my-fi-25073/KEYrschwein/README.md

# Kirschwein
Kirschwein KBD PCB - RC-2XXX
