my-fi-25073/KEYrschwein/OtherFiles/F-edge.dxf

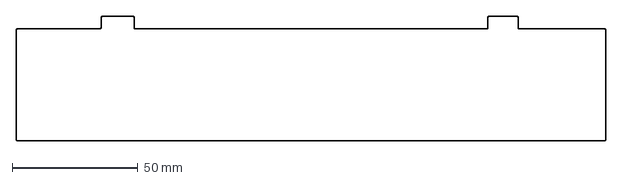
[picture p1: CAD file, 2026-03-09]
OtherFiles/F-edge.dxf
234.0 x 49.5 mm
