my-fi-25073/KEYrschwein/OtherFiles/Kirschwein-2xxa-edge.dxf

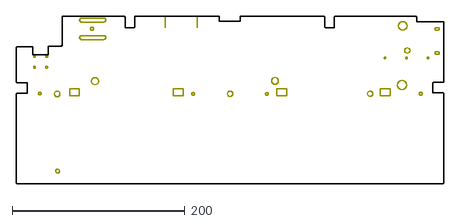
[picture p2: CAD file, 2026-02-23]
OtherFiles/Kirschwein-2xxa-edge.dxf
494.6 x 193.6
