my-fi-25073/KEYrschwein/OtherFiles/2xxx-edge.dxf

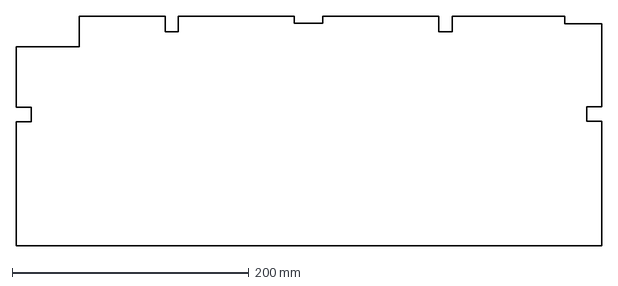
[picture p3: CAD file, 2025-12-20]
OtherFiles/2xxx-edge.dxf
494.6 x 193.6 mm
