my-fi-25073/KEYrschwein/OtherFiles/frow-edge.dxf

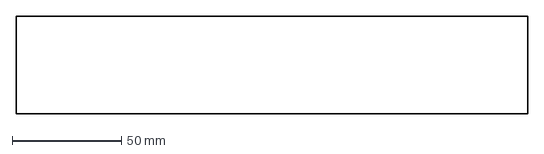
[picture p4: CAD file, 2025-12-20]
OtherFiles/frow-edge.dxf
234.0 x 44.5 mm
