my-fi-25073/KEYrschwein/KiCadFiles/GRAPPA-LEAF20/LEAF20.kicad_pcb

## KiCad design KiCadFiles/GRAPPA-LEAF20/LEAF20.kicad_pcb (2026-03-22)

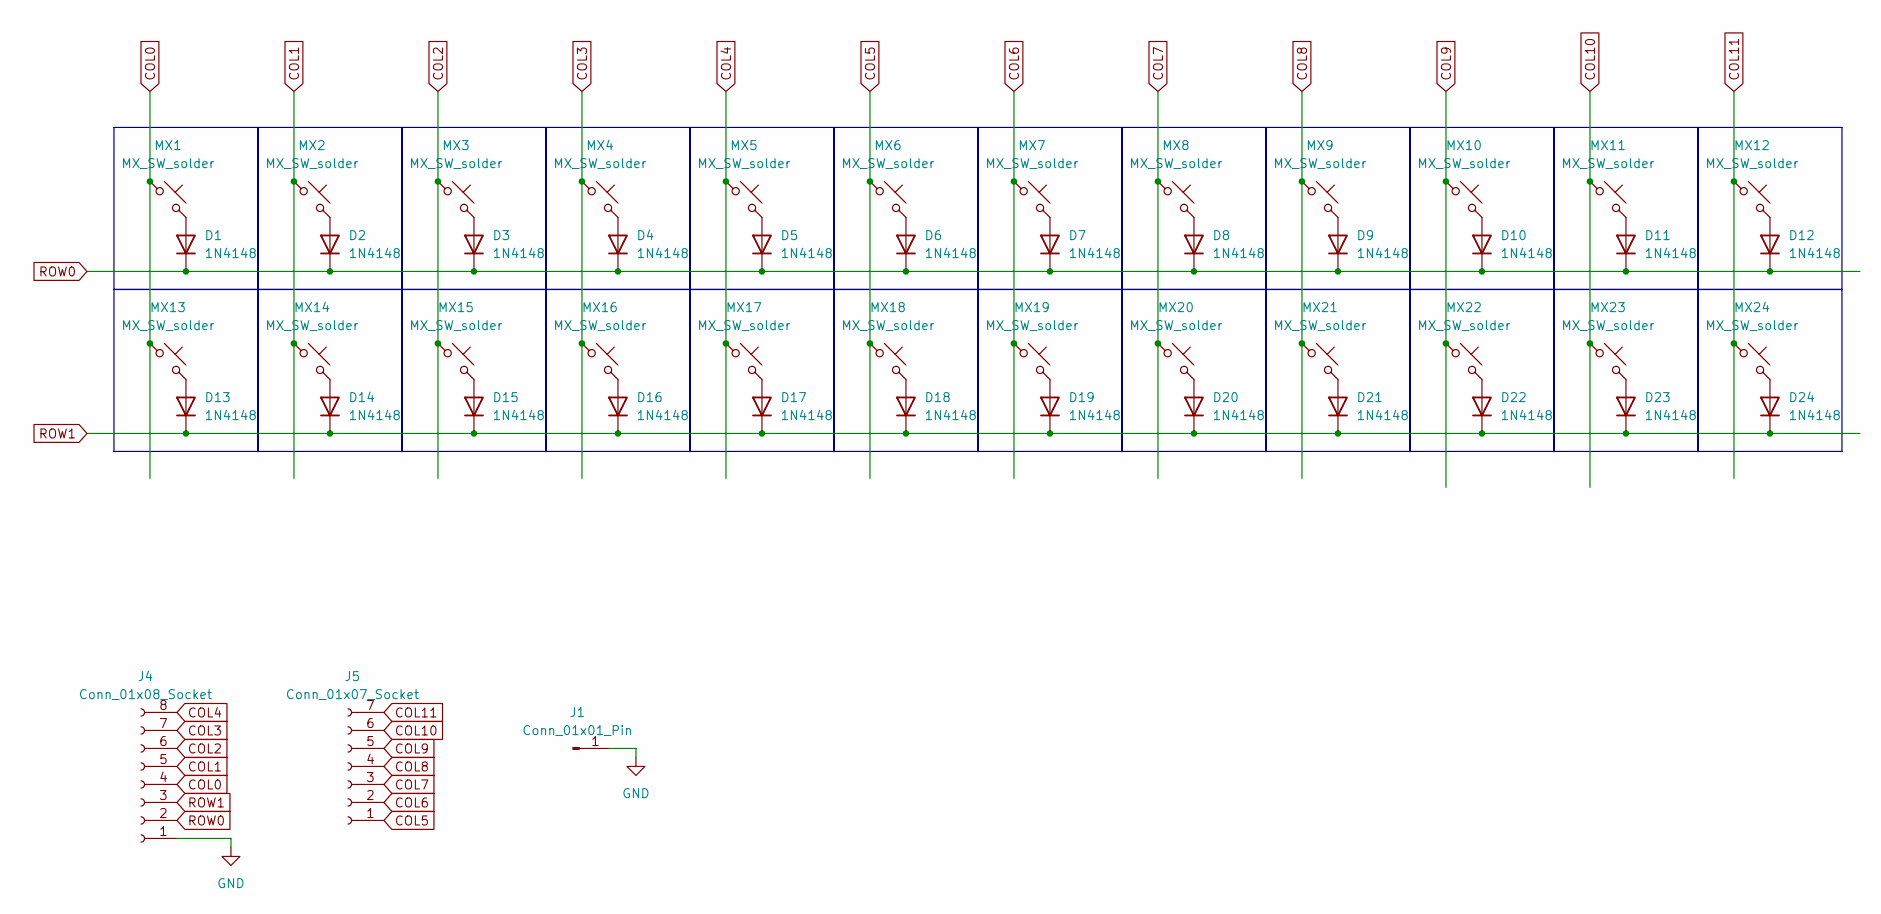
[picture p5: schematic LEAF20.kicad_sch]

Parts:
D1, D2, D3, D4, D5, D6, D7, D8, D9, D10, D11, D12, D13, D14, D15, D16, D17, D18, D19, D20, D21, D22, D23, D24: 1N4148; D_SOD-123-g
J1: Conn_01x01_Pin; SolderWire-0.75sqmm_1x01_D1.25mm_OD2.3mm
J4: Conn_01x08_Socket; JST_SH_SM08B-SRSS-TB_1x08-1MP_P1.00mm_Horizontal
J5: Conn_01x07_Socket; JST_SH_SM07B-SRSS-TB_1x07-1MP_P1.00mm_Horizontal
MX1, MX2, MX3, MX4, MX5, MX6, MX7, MX8, MX9, MX10, MX11, MX12, MX13, MX14, MX15, MX16, MX17, MX18, MX19, MX20, MX21, MX22, MX23, MX24: MX_SW_solder; SW_MX_1u

Connections:
COL0: J4.4, MX1.1, MX13.1
COL1: J4.5, MX2.1, MX14.1
COL2: J4.6, MX3.1, MX15.1
COL3: J4.7, MX4.1, MX16.1
COL4: J4.8, MX5.1, MX17.1
COL5: J5.1, MX6.1, MX18.1
COL6: J5.2, MX7.1, MX19.1
COL7: J5.3, MX8.1, MX20.1
COL8: J5.4, MX9.1, MX21.1
COL9: J5.5, MX10.1, MX22.1
COL10: J5.6, MX11.1, MX23.1
COL11: J5.7, MX12.1, MX24.1
GND: J1.1, J4.1
unnamed: D1.2 (A), MX1.2
unnamed: D2.2 (A), MX2.2
unnamed: D3.2 (A), MX3.2
unnamed: D4.2 (A), MX4.2
unnamed: D5.2 (A), MX5.2
unnamed: D6.2 (A), MX6.2
unnamed: D7.2 (A), MX7.2
unnamed: D8.2 (A), MX8.2
unnamed: D9.2 (A), MX9.2
unnamed: D10.2 (A), MX10.2
unnamed: D11.2 (A), MX11.2
unnamed: D12.2 (A), MX12.2
unnamed: D13.2 (A), MX13.2
unnamed: D14.2 (A), MX14.2
unnamed: D15.2 (A), MX15.2
unnamed: D16.2 (A), MX16.2
unnamed: D17.2 (A), MX17.2
unnamed: D18.2 (A), MX18.2
unnamed: D19.2 (A), MX19.2
unnamed: D20.2 (A), MX20.2
unnamed: D21.2 (A), MX21.2
unnamed: D22.2 (A), MX22.2
unnamed: D23.2 (A), MX23.2
unnamed: D24.2 (A), MX24.2
ROW0: D1.1 (K), D2.1 (K), D3.1 (K), D4.1 (K), D5.1 (K), D6.1 (K), D7.1 (K), D8.1 (K), D9.1 (K), D10.1 (K), D11.1 (K), D12.1 (K), J4.2
ROW1: D13.1 (K), D14.1 (K), D15.1 (K), D16.1 (K), D17.1 (K), D18.1 (K), D19.1 (K), D20.1 (K), D21.1 (K), D22.1 (K), D23.1 (K), D24.1 (K), J4.3

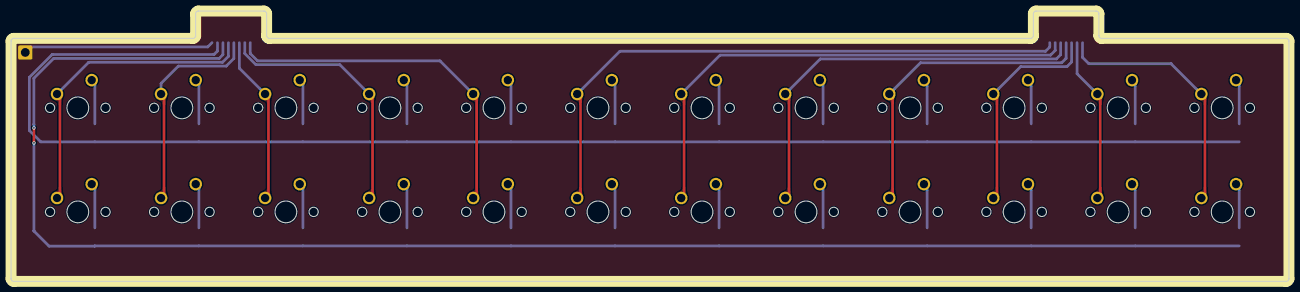
[picture p6: board LEAF20.kicad_pcb from above]

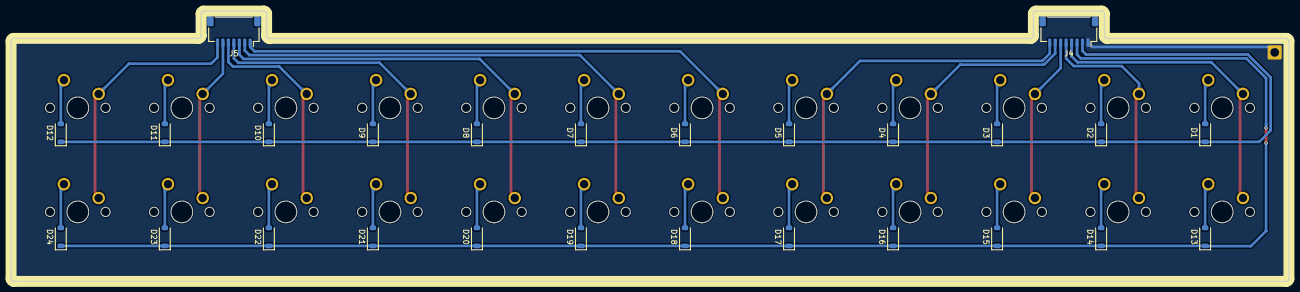
[picture p7: board LEAF20.kicad_pcb from below]

Board: 2 copper layers, 234.0 x 49.5 mm, 51 parts (27 on the bottom side), 39 nets.
