my-fi-25073/KEYrschwein/KiCadFiles/RC-2XXA/RC-2XXA.kicad_pcb

## KiCad design KiCadFiles/RC-2XXA/RC-2XXA.kicad_pcb (2026-03-02)

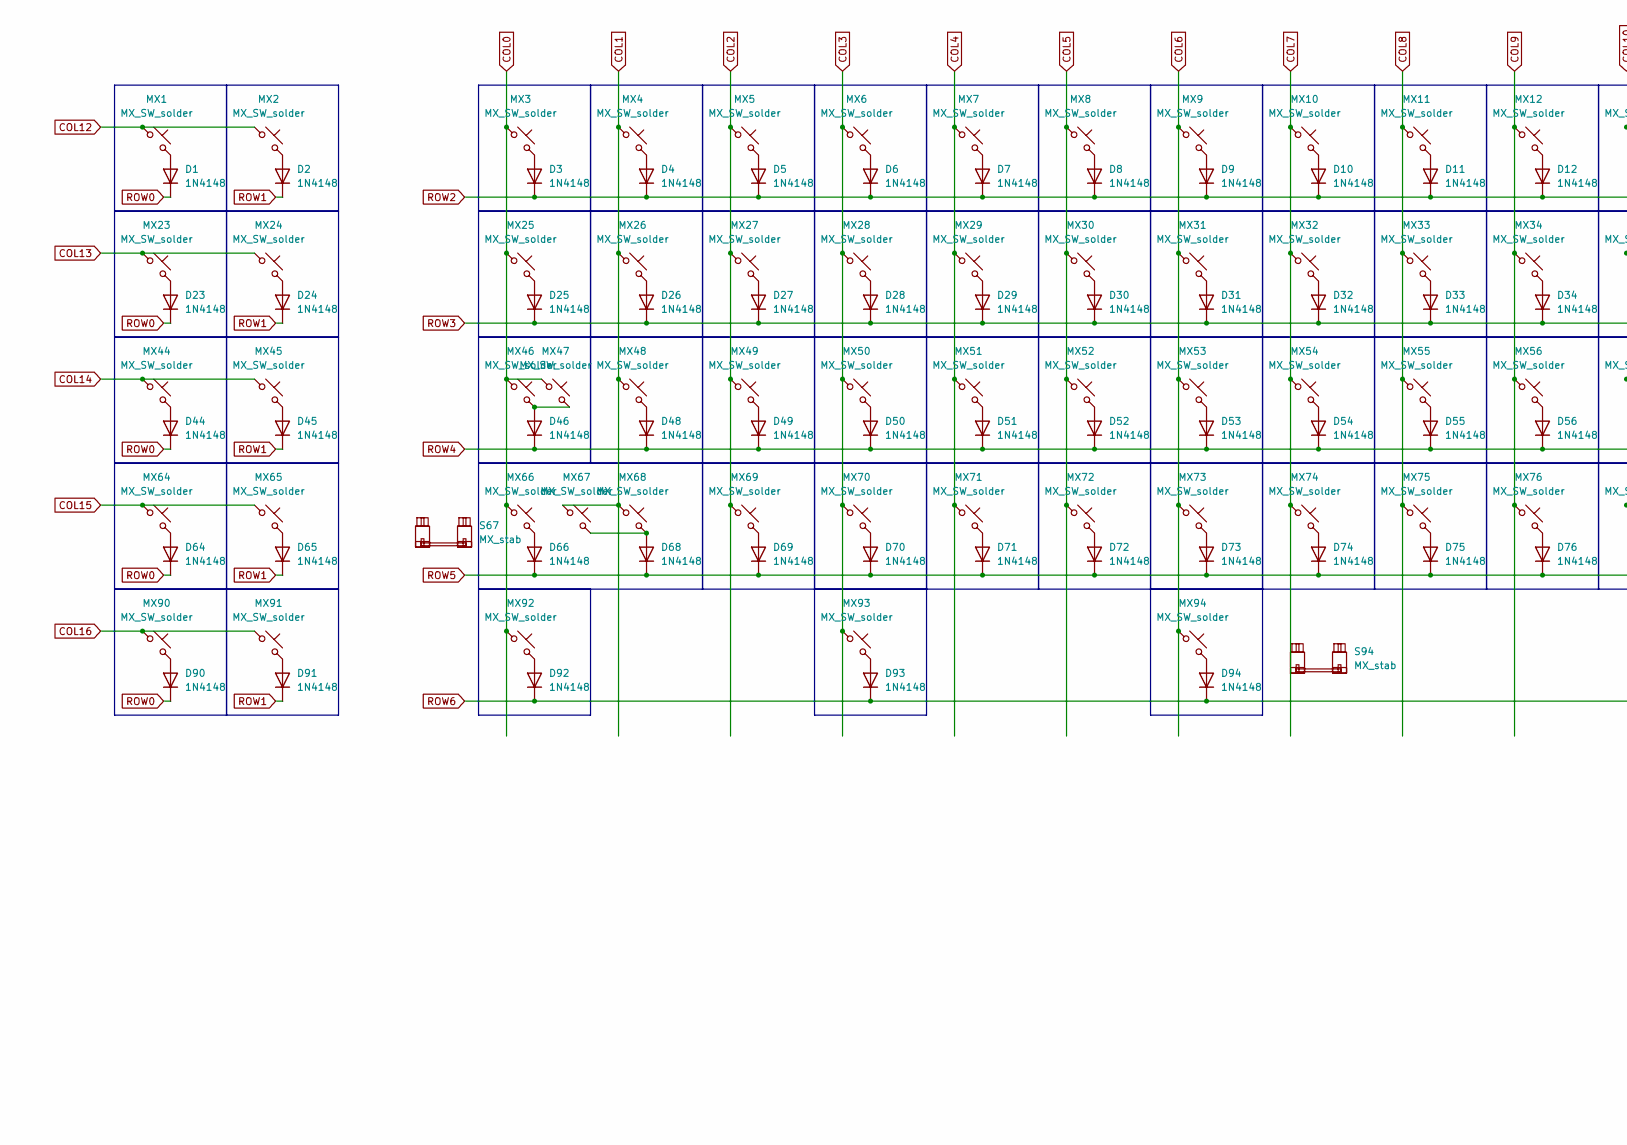
[picture p8: schematic RC-2XXA.kicad_sch, part in row 1, column 1]

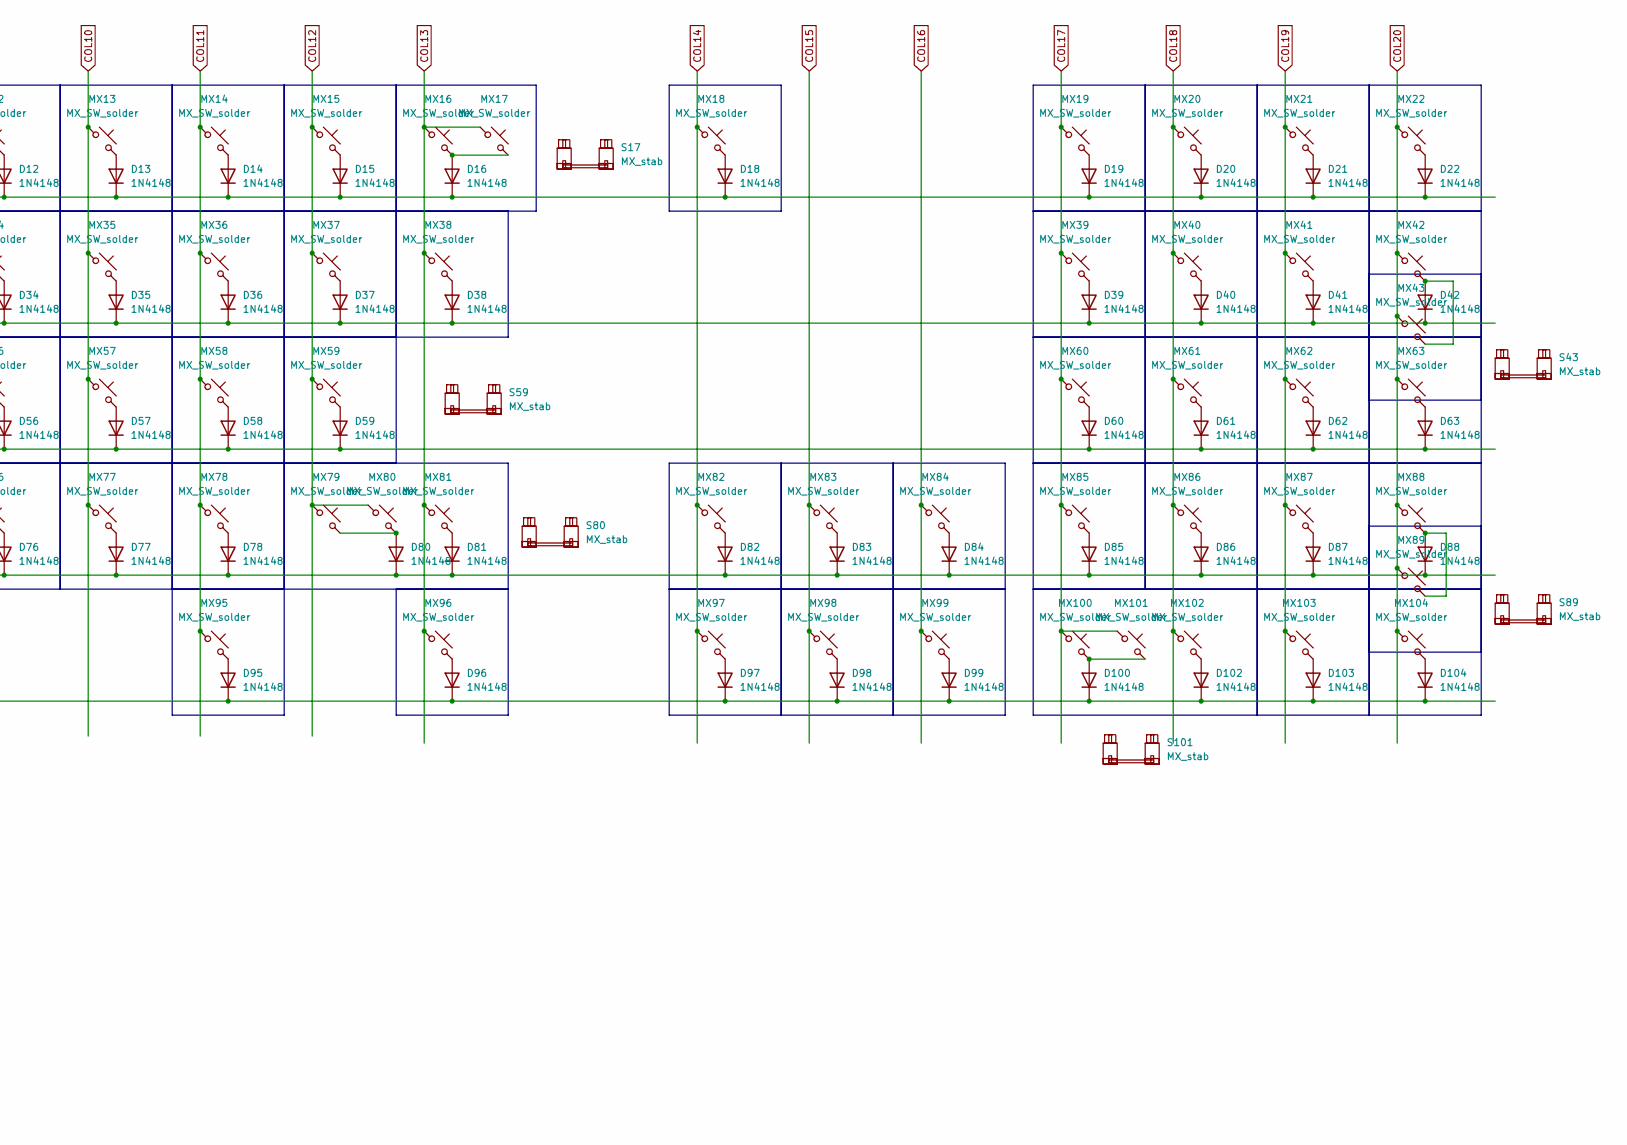
[picture p9: schematic RC-2XXA.kicad_sch, part in row 1, column 2]

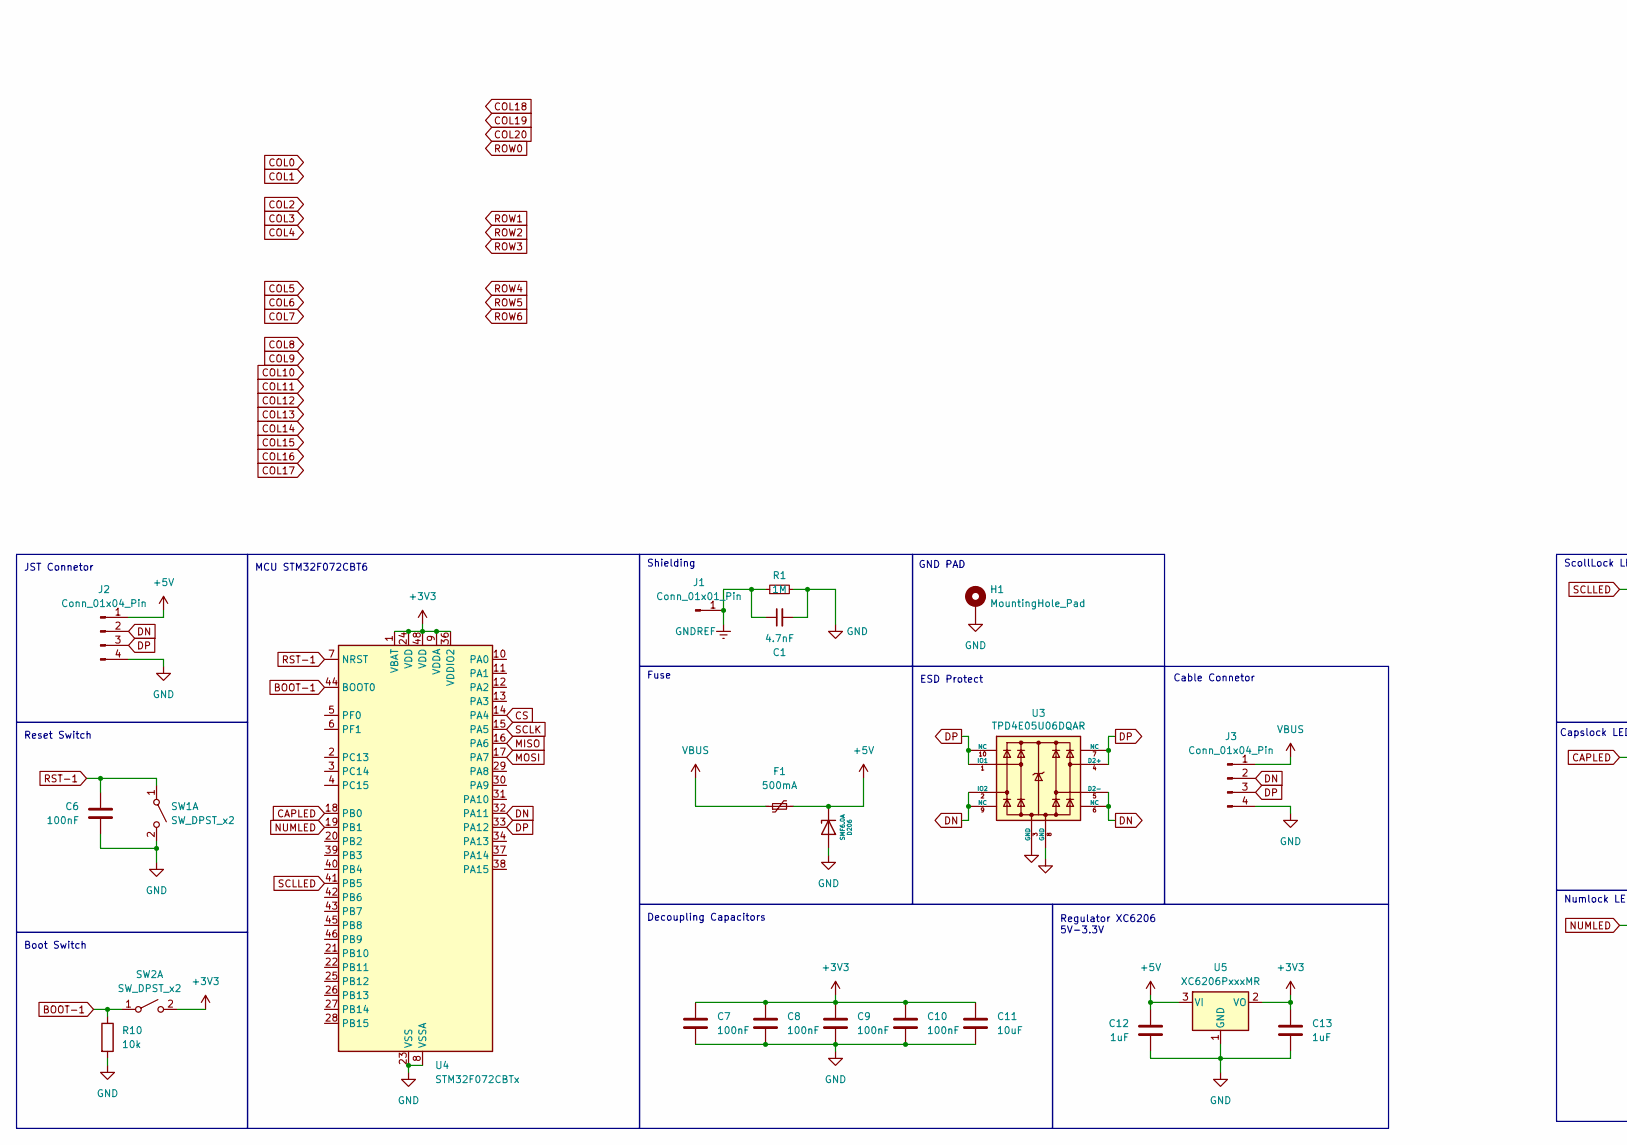
[picture p10: schematic RC-2XXA.kicad_sch, part in row 2, column 1]

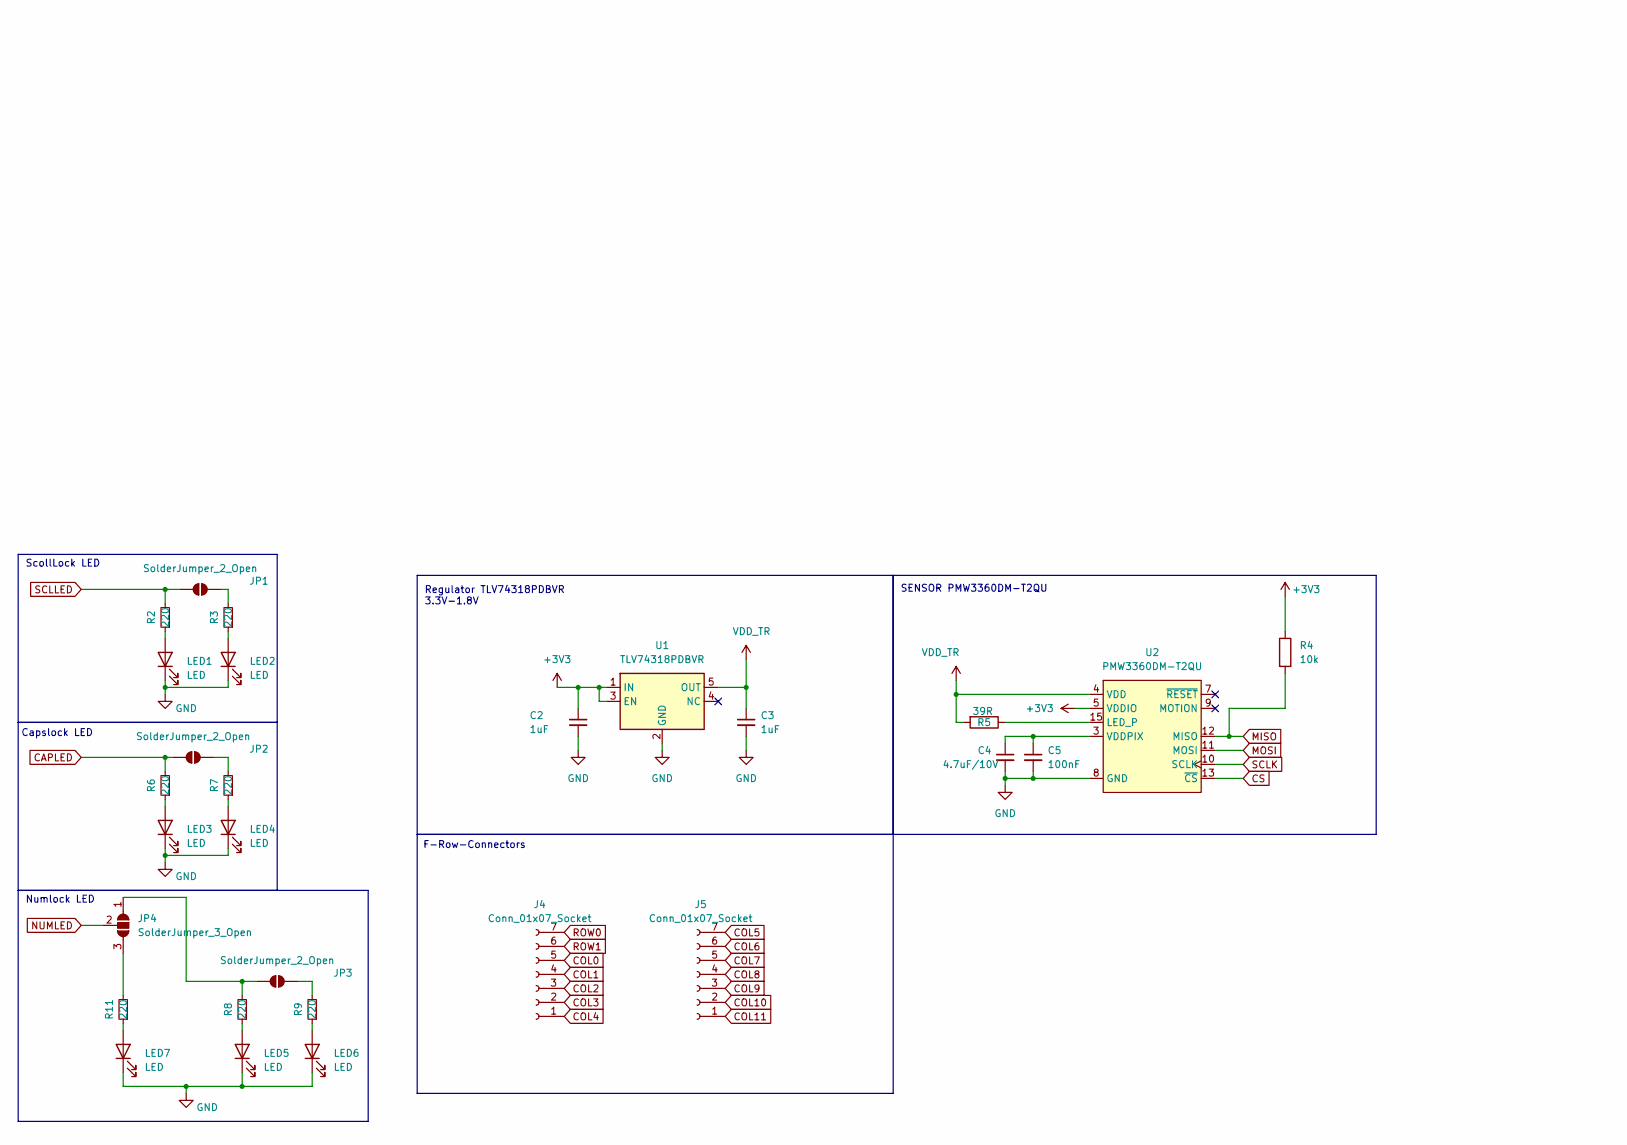
[picture p11: schematic RC-2XXA.kicad_sch, part in row 2, column 2]

Parts:
C1: 4.7nF; C_0805_2012Metric_Pad1.18x1.45mm_HandSolder
C2, C3, C12, C13: 1uF; C_0805_2012Metric_Pad1.18x1.45mm_HandSolder
C4: 4.7uF/10V; C_0805_2012Metric_Pad1.18x1.45mm_HandSolder
C5, C6, C7, C8, C9, C10: 100nF; C_0805_2012Metric_Pad1.18x1.45mm_HandSolder
C11: 10uF; C_0805_2012Metric_Pad1.18x1.45mm_HandSolder
D1, D2, D3, D4, D5, D6, D7, D8, D9, D10, D11, D12, D13, D14, D15, D16, D18, D19, D20, D21, D22, D23, D24, D25, D26, D27, D28, D29, D30, D31, D32, D33, D34, D35, D36, D37, D38, D39, D40, D41, D42, D44, D45, D46, D48, D49, D50, D51, D52, D53, D54, D55, D56, D57, D58, D59, D60, D61, D62, D63, D64, D65, D66, D68, D69, D70, D71, D72, D73, D74, D75, D76, D77, D78, D80, D81, D82, D83, D84, D85, D86, D87, D88, D90, D91, D92, D93, D94, D95, D96, D97, D98, D99, D100, D102, D103, D104: 1N4148; D_SOD-123-g
D206: SMF6.0A; D_SOD-123; Manufacturer Part Number SMF6.0A; LCSC Part Number C708002
F1: 500mA; Fuse_1206_3216Metric; LCSC C70076
H1: MountingHole_Pad; Cherry-GND-PAD
J1: Conn_01x01_Pin; TestPoint_THTPad_2.0x2.0mm_Drill1.0mm
J2: Conn_01x04_Pin; JST_SH_SM04B-SRSS-TB_1x04-1MP_P1.00mm_Horizontal; MPN C160404
J3: Conn_01x04_Pin; My-SolderWire-0.5sqmm_1x04_D0.9mm_OD2.1mm
J4, J5: Conn_01x07_Socket; JST_SH_SM07B-SRSS-TB_1x07-1MP_P1.00mm_Horizontal
JP1, JP2, JP3: SolderJumper_2_Open; SolderJumper-2_P1.3mm_Open_RoundedPad1.0x1.5mm
JP4: SolderJumper_3_Open; SolderJumper-3_P1.3mm_Open_RoundedPad1.0x1.5mm
LED1, LED2, LED4, LED5, LED6, LED7: LED; DIP_LED_MX_3mm
LED3: LED; CAPS_LED_MX_3mm
MX1, MX2, MX3, MX4, MX5, MX6, MX7, MX8, MX9, MX10, MX11, MX12, MX13, MX14, MX15, MX16, MX17, MX18, MX19, MX20, MX21, MX22, MX23, MX24, MX26, MX27, MX28, MX29, MX30, MX31, MX32, MX33, MX34, MX35, MX36, MX37, MX39, MX40, MX41, MX42, MX43, MX44, MX45, MX48, MX49, MX50, MX51, MX52, MX53, MX54, MX55, MX56, MX57, MX58, MX59, MX60, MX61, MX62, MX63, MX64, MX65, MX66, MX67, MX69, MX70, MX71, MX72, MX73, MX74, MX75, MX76, MX77, MX78, MX80, MX81, MX82, MX83, MX84, MX85, MX86, MX87, MX88, MX89, MX90, MX91, MX94, MX97, MX98, MX99, MX100, MX101, MX102, MX103, MX104: MX_SW_solder; SW_MX_1u
MX25, MX38, MX92, MX93, MX95, MX96: MX_SW_solder; SW_MX_1.5u
MX46: MX_SW_solder; SW_MX_1.75u_STP_1.25
MX47, MX79: MX_SW_solder; SW_MX_1.75u
MX68: MX_SW_solder; SW_MX_1.25u
R1: 1M; R_0805_2012Metric_Pad1.20x1.40mm_HandSolder
R2, R3, R6, R7, R8, R9, R11: 220; R_0805_2012Metric_Pad1.20x1.40mm_HandSolder
R4, R10: 10k; R_0805_2012Metric_Pad1.20x1.40mm_HandSolder
R5: 39R; R_0805_2012Metric_Pad1.20x1.40mm_HandSolder
S17, S43, S89, S101: MX_stab; STAB_MX_2u
S59, S67: MX_stab; STAB_MX_2.25u
S80: MX_stab; STAB_MX_2.75u
S94: MX_stab; STAB_MX_7u
SW1, SW2: SW_DPST_x2; SW_Push_1P1T_XKB_TS-1187A; MPN C318884
U1: TLV74318PDBVR; SOT-23-5; MPN C485152
U2: PMW3360DM-T2QU; TrackballHolder_34mm
U3: TPD4E05U06DQAR; USON-10_2.5x1.0mm_P0.5mm; Manufacturer Part Number TPD4E05U06DQAR; LCSC Part Number C138714
U4: STM32F072CBTx; LQFP-48_7x7mm_P0.5mm; MPN C81720
U5: XC6206PxxxMR; SOT-23-3; MPN C5148692

Connections:
+3V3: C2.1, C7.1, C8.1, C9.1, C10.1, C11.1, C13.1, R4.1, SW2.2 (B), U1.1 (IN), U1.3 (EN), U2.5 (VDDIO), U4.1 (VBAT), U4.9 (VDDA), U4.24 (VDD), U4.36 (VDDIO2), U4.48 (VDD), U5.2 (VO)
+5V: C12.1, D206.1 (K), F1.2, J2.1, U5.3 (VI)
BOOT-1: R10.1, SW2.1 (A), U4.44 (BOOT0)
CAPLED: JP2.1 (A), R6.2, U4.18 (PB0)
COL0: J4.5, MX3.1, MX25.1, MX46.1, MX47.1, MX66.1, MX92.1
COL1: J4.4, MX4.1, MX26.1, MX48.1, MX67.1, MX68.1
COL2: J4.3, MX5.1, MX27.1, MX49.1, MX69.1
COL3: J4.2, MX6.1, MX28.1, MX50.1, MX70.1, MX93.1
COL4: J4.1, MX7.1, MX29.1, MX51.1, MX71.1
COL5: J5.7, MX8.1, MX30.1, MX52.1, MX72.1
COL6: J5.6, MX9.1, MX31.1, MX53.1, MX73.1, MX94.1
COL7: J5.5, MX10.1, MX32.1, MX54.1, MX74.1
COL8: J5.4, MX11.1, MX33.1, MX55.1, MX75.1
COL9: J5.3, MX12.1, MX34.1, MX56.1, MX76.1
COL10: J5.2, MX13.1, MX35.1, MX57.1, MX77.1
COL11: J5.1, MX14.1, MX36.1, MX58.1, MX78.1, MX95.1
COL12: MX1.1, MX2.1, MX15.1, MX37.1, MX59.1, MX79.1, MX80.1
COL13: MX16.1, MX17.1, MX23.1, MX24.1, MX38.1, MX81.1, MX96.1
COL14: MX18.1, MX44.1, MX45.1, MX82.1, MX97.1
COL15: MX64.1, MX65.1, MX83.1, MX98.1
COL16: MX84.1, MX90.1, MX91.1, MX99.1
COL17: MX19.1, MX39.1, MX60.1, MX85.1, MX100.1, MX101.1
COL18: MX20.1, MX40.1, MX61.1, MX86.1, MX102.1
COL19: MX21.1, MX41.1, MX62.1, MX87.1, MX103.1
COL20: MX22.1, MX42.1, MX43.1, MX63.1, MX88.1, MX89.1, MX104.1
CS: U2.13 (~CS), U4.14 (PA4)
DN: J2.2, J3.2, U3.2 (IO2), U3.5 (D2-), U3.6 (NC), U3.9 (NC), U4.32 (PA11)
DP: J2.3, J3.3, U3.1 (IO1), U3.4 (D2+), U3.7 (NC), U3.10 (NC), U4.33 (PA12)
GND: C1.2, C2.2, C3.2, C4.2, C5.2, C6.2, C7.2, C8.2, C9.2, C10.2, C11.2, C12.2, C13.2, D206.2 (A), H1.1, J2.4, J3.4, LED1.1 (K), LED2.1 (K), LED3.1 (K), LED4.1 (K), LED5.1 (K), LED6.1 (K), LED7.1 (K), R1.2, R10.2, SW1.2 (B), U1.2 (GND), U2.8 (GND), U3.3 (GND), U3.8 (GND), U4.8 (VSSA), U4.23 (VSS), U4.35 (VSS), U4.47 (VSS), U5.1 (GND)
GNDREF: C1.1, J1.1, R1.1
MISO: R4.2, U2.12 (MISO), U4.16 (PA6)
MOSI: U2.11 (MOSI), U4.17 (PA7)
NUMLED: JP4.2 (C), U4.19 (PB1)
unnamed: D1.2 (A), MX1.2
unnamed: D2.2 (A), MX2.2
unnamed: D3.2 (A), MX3.2
unnamed: D4.2 (A), MX4.2
unnamed: D5.2 (A), MX5.2
unnamed: D6.2 (A), MX6.2
unnamed: D7.2 (A), MX7.2
unnamed: D8.2 (A), MX8.2
unnamed: D9.2 (A), MX9.2
unnamed: D10.2 (A), MX10.2
unnamed: D11.2 (A), MX11.2
unnamed: D12.2 (A), MX12.2
unnamed: D13.2 (A), MX13.2
unnamed: D14.2 (A), MX14.2
unnamed: D15.2 (A), MX15.2
unnamed: D16.2 (A), MX16.2, MX17.2
unnamed: D18.2 (A), MX18.2
unnamed: D19.2 (A), MX19.2
unnamed: D20.2 (A), MX20.2
unnamed: D21.2 (A), MX21.2
unnamed: D22.2 (A), MX22.2
unnamed: D23.2 (A), MX23.2
unnamed: D24.2 (A), MX24.2
unnamed: D25.2 (A), MX25.2
unnamed: D26.2 (A), MX26.2
unnamed: D27.2 (A), MX27.2
unnamed: D28.2 (A), MX28.2
unnamed: D29.2 (A), MX29.2
unnamed: D30.2 (A), MX30.2
unnamed: D31.2 (A), MX31.2
unnamed: D32.2 (A), MX32.2
unnamed: D33.2 (A), MX33.2
unnamed: D34.2 (A), MX34.2
unnamed: D35.2 (A), MX35.2
unnamed: D36.2 (A), MX36.2
unnamed: D37.2 (A), MX37.2
unnamed: D38.2 (A), MX38.2
unnamed: D39.2 (A), MX39.2
unnamed: D40.2 (A), MX40.2
unnamed: D41.2 (A), MX41.2
unnamed: D42.2 (A), MX42.2, MX43.2
unnamed: D44.2 (A), MX44.2
unnamed: D45.2 (A), MX45.2
unnamed: D46.2 (A), MX46.2, MX47.2
unnamed: D48.2 (A), MX48.2
unnamed: D49.2 (A), MX49.2
unnamed: D50.2 (A), MX50.2
unnamed: D51.2 (A), MX51.2
unnamed: D52.2 (A), MX52.2
unnamed: D53.2 (A), MX53.2
unnamed: D54.2 (A), MX54.2
unnamed: D55.2 (A), MX55.2
unnamed: D56.2 (A), MX56.2
unnamed: D57.2 (A), MX57.2
unnamed: D58.2 (A), MX58.2
unnamed: D59.2 (A), MX59.2
unnamed: D60.2 (A), MX60.2
unnamed: D61.2 (A), MX61.2
unnamed: D62.2 (A), MX62.2
unnamed: D63.2 (A), MX63.2
unnamed: D64.2 (A), MX64.2
unnamed: D65.2 (A), MX65.2
unnamed: D66.2 (A), MX66.2
unnamed: D68.2 (A), MX67.2, MX68.2
unnamed: D69.2 (A), MX69.2
unnamed: D70.2 (A), MX70.2
unnamed: D71.2 (A), MX71.2
unnamed: D72.2 (A), MX72.2
unnamed: D73.2 (A), MX73.2
unnamed: D74.2 (A), MX74.2
unnamed: D75.2 (A), MX75.2
unnamed: D76.2 (A), MX76.2
unnamed: D77.2 (A), MX77.2
unnamed: D78.2 (A), MX78.2
unnamed: D80.2 (A), MX79.2, MX80.2
unnamed: D81.2 (A), MX81.2
unnamed: D82.2 (A), MX82.2
unnamed: D83.2 (A), MX83.2
unnamed: D84.2 (A), MX84.2
unnamed: D85.2 (A), MX85.2
unnamed: D86.2 (A), MX86.2
unnamed: D87.2 (A), MX87.2
unnamed: D88.2 (A), MX88.2, MX89.2
unnamed: D90.2 (A), MX90.2
unnamed: D91.2 (A), MX91.2
unnamed: D92.2 (A), MX92.2
unnamed: D93.2 (A), MX93.2
unnamed: D94.2 (A), MX94.2
unnamed: D95.2 (A), MX95.2
unnamed: D96.2 (A), MX96.2
unnamed: D97.2 (A), MX97.2
unnamed: D98.2 (A), MX98.2
unnamed: D99.2 (A), MX99.2
unnamed: D100.2 (A), MX100.2, MX101.2
unnamed: D102.2 (A), MX102.2
unnamed: D103.2 (A), MX103.2
unnamed: D104.2 (A), MX104.2
unnamed: JP1.2 (B), R3.2
unnamed: JP2.2 (B), R7.2
unnamed: JP3.1 (A), JP4.1 (A), R8.2
unnamed: JP3.2 (B), R9.2
unnamed: JP4.3 (B), R11.2
unnamed: LED1.2 (A), R2.1
unnamed: LED2.2 (A), R3.1
unnamed: LED3.2 (A), R6.1
unnamed: LED4.2 (A), R7.1
unnamed: LED5.2 (A), R8.1
unnamed: LED6.2 (A), R9.1
unnamed: LED7.2 (A), R11.1
unnamed: R5.1, U2.15 (LED_P)
unnamed: C4.1, C5.1, U2.3 (VDDPIX)
ROW0: D1.1 (K), D23.1 (K), D44.1 (K), D64.1 (K), D90.1 (K), J4.7
ROW1: D2.1 (K), D24.1 (K), D45.1 (K), D65.1 (K), D91.1 (K), J4.6
ROW2: D3.1 (K), D4.1 (K), D5.1 (K), D6.1 (K), D7.1 (K), D8.1 (K), D9.1 (K), D10.1 (K), D11.1 (K), D12.1 (K), D13.1 (K), D14.1 (K), D15.1 (K), D16.1 (K), D18.1 (K), D19.1 (K), D20.1 (K), D21.1 (K), D22.1 (K)
ROW3: D25.1 (K), D26.1 (K), D27.1 (K), D28.1 (K), D29.1 (K), D30.1 (K), D31.1 (K), D32.1 (K), D33.1 (K), D34.1 (K), D35.1 (K), D36.1 (K), D37.1 (K), D38.1 (K), D39.1 (K), D40.1 (K), D41.1 (K), D42.1 (K)
ROW4: D46.1 (K), D48.1 (K), D49.1 (K), D50.1 (K), D51.1 (K), D52.1 (K), D53.1 (K), D54.1 (K), D55.1 (K), D56.1 (K), D57.1 (K), D58.1 (K), D59.1 (K), D60.1 (K), D61.1 (K), D62.1 (K), D63.1 (K)
ROW5: D66.1 (K), D68.1 (K), D69.1 (K), D70.1 (K), D71.1 (K), D72.1 (K), D73.1 (K), D74.1 (K), D75.1 (K), D76.1 (K), D77.1 (K), D78.1 (K), D80.1 (K), D81.1 (K), D82.1 (K), D83.1 (K), D84.1 (K), D85.1 (K), D86.1 (K), D87.1 (K), D88.1 (K)
ROW6: D92.1 (K), D93.1 (K), D94.1 (K), D95.1 (K), D96.1 (K), D97.1 (K), D98.1 (K), D99.1 (K), D100.1 (K), D102.1 (K), D103.1 (K), D104.1 (K)
RST-1: C6.1, SW1.1 (A), U4.7 (NRST)
SCLK: U2.10 (SCLK), U4.15 (PA5)
SCLLED: JP1.1 (A), R2.2, U4.41 (PB5)
VBUS: F1.1, J3.1
VDD_TR: C3.1, R5.2, U1.5 (OUT), U2.4 (VDD)

Notes on the sheet:
MCU STM32F072CBT6
Numlock LED
Cable Connetor
Shielding
ScollLock LED
Reset Switch
Decoupling Capacitors
Boot Switch
Regulator XC6206 5V-3.3V
JST Connetor
Capslock LED
SENSOR PMW3360DM-T2QU
ESD Protect
F-Row-Connectors
Regulator TLV74318PDBVR 3.3V-1.8V
Fuse
GND PAD

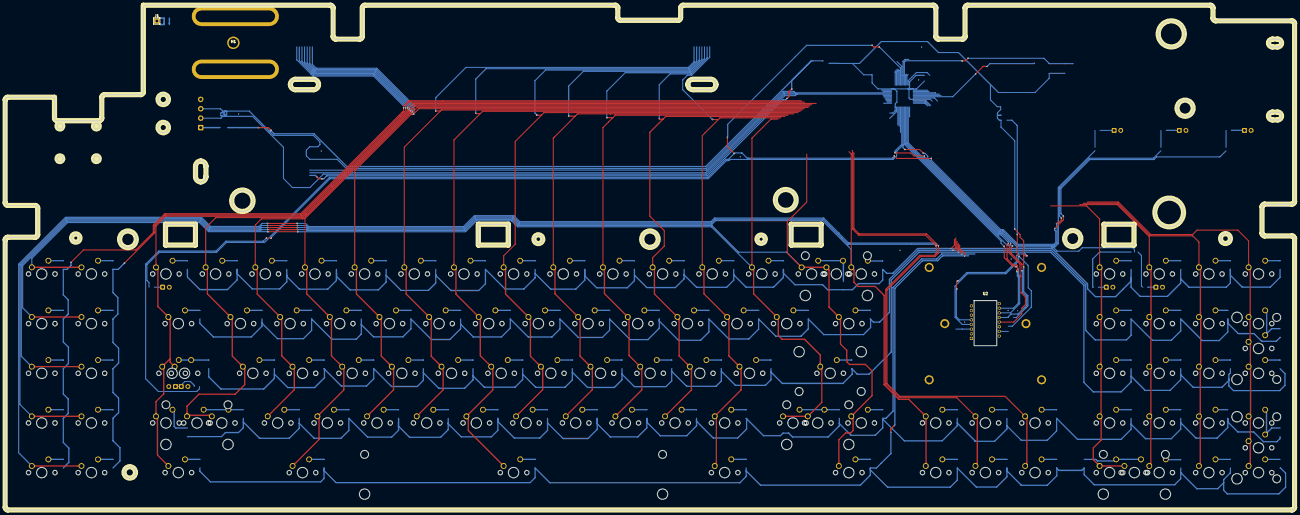
[picture p12: board RC-2XXA.kicad_pcb from above]

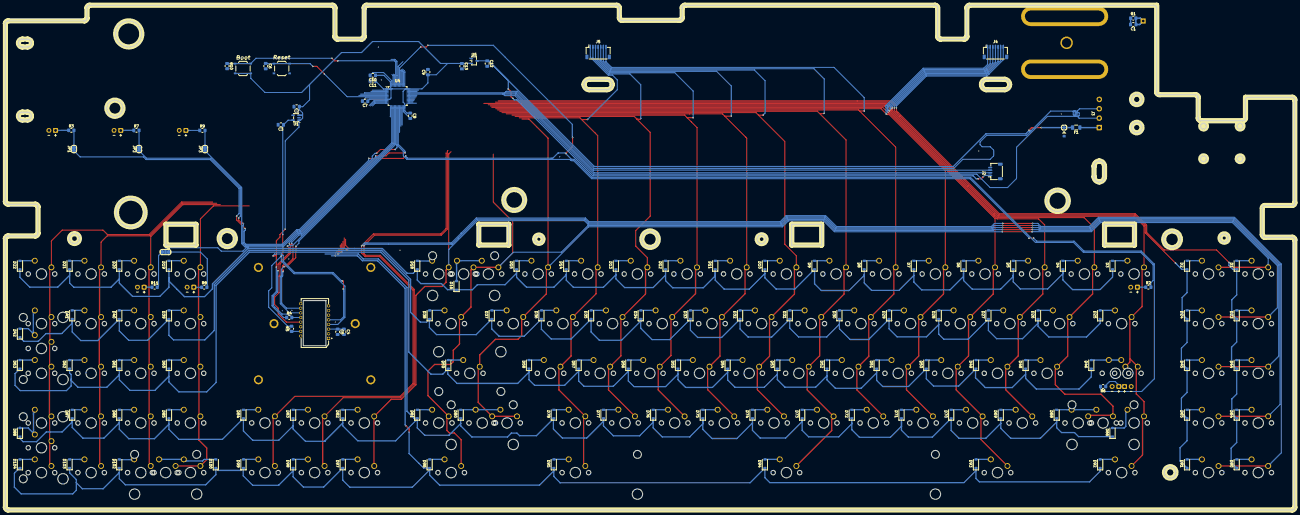
[picture p13: board RC-2XXA.kicad_pcb from below]

Board: 2 copper layers, 494.6 x 193.6 mm, 259 parts (137 on the bottom side), 156 nets.
