my-fi-25073/KEYrschwein/(commit log)

2025-12-20 Add new DXF files: 2xxx-edge.dxf and frow-edge.dxf
    [2xxx-edge.dxf, frow-edge.dxf]
2025-12-22 Add new KiCad project files for LEAF20, NAN40, TAN40, and RC-2XXX, including PCB, schematic, and project files. Update .gitignore to exclude keyautoplace.log files. Add JSON placer files for each pro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
    [LEAF20.kicad_pcb, LEAF20.kicad_sch, NAN-40.kicad_pcb, NAN-40.kicad_sch, RC-2XXX.kicad_pcb, RC-2XXX.kicad_sch, TAN40.kicad_pcb, TAN40.kicad_sch]
2025-12-23 Add new KiCad project files for RC-2XXA, including PCB, schematic, and project files. Update existing schematic for RC-2XXX to adjust paper size and reposition components.
    [LEAF20.kicad_pcb, RC-2XXA.kicad_pcb, RC-2XXA.kicad_sch, RC-2XXX.kicad_sch]
2026-02-09 Refactor KiCad project files for RC-2XXA: streamline net connections in PCB, adjust solder mask clearance in project settings, and add new connector symbols in schematic. Enhance error handling for u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
    [RC-2XXA.kicad_pcb, RC-2XXA.kicad_sch]
2026-02-10 Update rectangle positions in RC-2XXA schematic to correct alignment and spacing. Adjust multiple rectangle coordinates for improved layout consistency.
    [RC-2XXA.kicad_sch]
2026-02-10 Update .gitignore to exclude additional KiCad files for RC-2XXA, including production files and fabrication toolkit options.
2026-02-12 Update RC-2XXA KiCad files: adjust footprint properties, correct rectangle positions in schematic, and enhance error handling for pin connections. Remove unnecessary junctions and wires for improved 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
    [RC-2XXA.kicad_pcb, RC-2XXA.kicad_sch]
2026-02-12 Add Zener diode symbol to RC-2XXA schematic, update component references and footprints for capacitors and resistors, and correct wire connections for improved circuit clarity.
    [RC-2XXA.kicad_sch]
2026-02-12 Add netlist for RC-2XXA schematic, including detailed component specifications for capacitors and their properties. This file establishes the electrical connections and design parameters for the proj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
2026-02-17 updated pcb & sch
    [RC-2XXA.kicad_pcb, RC-2XXA.kicad_sch]
2026-02-17 feat(kicad): sync RC-2XXA schematic/PCB and add routing presets
    [RC-2XXA.kicad_pcb, RC-2XXA.kicad_sch]
2026-02-23 Refactor code structure for improved readability and maintainability
    [F-edge.dxf, Kirschwein-2xxa-edge.dxf, RC-2XXA.kicad_pcb, RC-2XXA.kicad_sch]
2026-02-24 Implement code changes to enhance functionality and improve performance
    [RC-2XXA.kicad_pcb]
2026-02-27 Update RC-2XXA project files: Adjust minimum clearance and modify connector properties
    - Changed minimum clearance in RC-2XXA.kicad_pro from 0.5 to 0.26.
    - Updated the "Value" property of a component in RC-2XXA.kicad_sch from "VBUS" to "+5V".
    - Added a new connector symbol with detailed properties including reference, value, footprint, and description.
    - Removed the old connector symbol to avoid duplication.
    [RC-2XXA.kicad_pcb, RC-2XXA.kicad_sch]
2026-02-27 Add Solder Jumper component and associated wiring to RC-2XXA schematic
    - Introduced a new Solder Jumper component (JP) with properties including reference, value, footprint, and description.
    - Added multiple instances of the Solder Jumper at specified coordinates in the schematic.
    - Updated wiring to accommodate the new component, ensuring proper connections.
    [RC-2XXA.kicad_pcb, RC-2XXA.kicad_sch]
2026-03-01 Add Mounting Hole Pad and GND symbol to schematic
    - Introduced a new symbol for a mounting hole pad with properties including reference, value, footprint, and description.
    - Added a graphical representation of the mounting hole pad with a circle.
    - Included a GND symbol with properties for reference, value, and description, creating a global label for ground.
    - Updated the schematic layout to accommodate the new components.
    [RC-2XXA.kicad_pcb, RC-2XXA.kicad_sch]
2026-03-02 Add Solder Jumper and update component positions in schematic
    - Introduced a new Solder Jumper component (JP4) with properties and graphical representation.
    - Adjusted positions of several components including resistors (R8, R9, R11) and LEDs (LED6, LED7) for better layout.
    - Updated junctions and wire connections to reflect new component placements.
    - Removed redundant junctions and wires to clean up the schematic.
    [RC-2XXA.kicad_pcb, RC-2XXA.kicad_sch]
2026-03-26 Add custom keycode functionality and VIA support for 900Than9 keyboard
    - Implemented custom keycodes for various OS shortcuts including language switch, screenshot, and desktop navigation.
    - Created key handler functions to manage keycode processing based on the operating system.
    - Added a header file defining custom keycodes and keymap layers.
    - Included a readme file with build and flashing instructions for the keyboard.
    - Configured rules.mk to enable VIA and OS detection features.
    - Added visual representation of the keyboard layout in vi.json and via.json files.
    [my_config.c]
